Shiefav/KZ6C/hardware/ATTRIBUTION.md

# Hardware attribution

The board design contains footprints from the KiCad libraries. The local
`KZ6C.pretty/USB_C_HRO_TYPE-C-31-M-12.kicad_mod` is adapted from a KiCad library
footprint. KiCad libraries are CC BY-SA 4.0 with the KiCad library exception:
https://www.kicad.org/libraries/license/ . The full CC BY-SA 4.0 text is in
`../LICENSES/CC-BY-SA-4.0.txt`; the KiCad exception is in
`../LICENSES/KICAD-LIBRARY-EXCEPTION.txt`. KiCad copyrights and third-party
notices continue to apply to their original material. Original KZ6C board and
case contributions are distributed under CC BY-SA 4.0, see `../LICENSE`.
