Shiefav/KZ6C/(list of files, cad)

Other CAD files:
case/bottom.dxf
case/spacer.dxf
case/top.dxf
