Shiefav/KZ6C/hardware/kz6c-b02.kicad_pcb

## KiCad design hardware/kz6c-b02.kicad_pcb (2026-11-12)

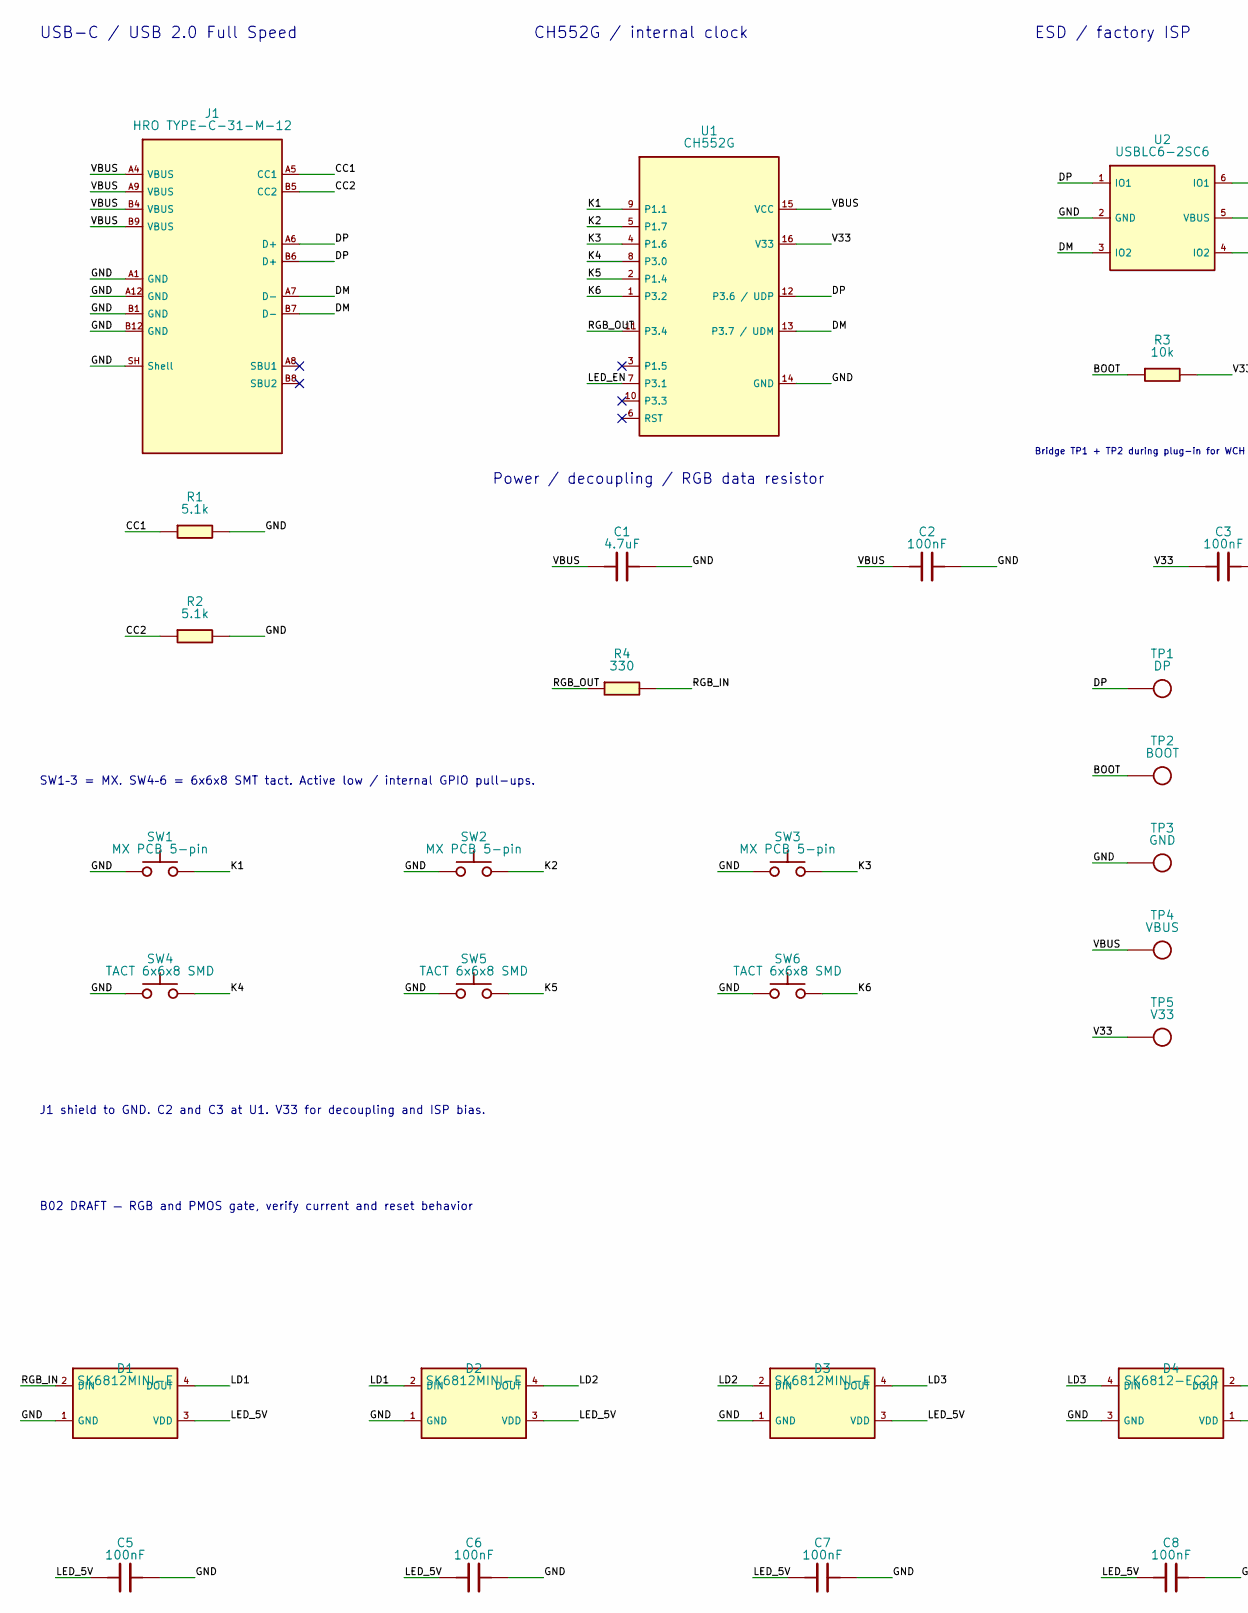
[picture p1: schematic kz6c-b02.kicad_sch, KeypadZone KZ6C, part in row 1, column 1]

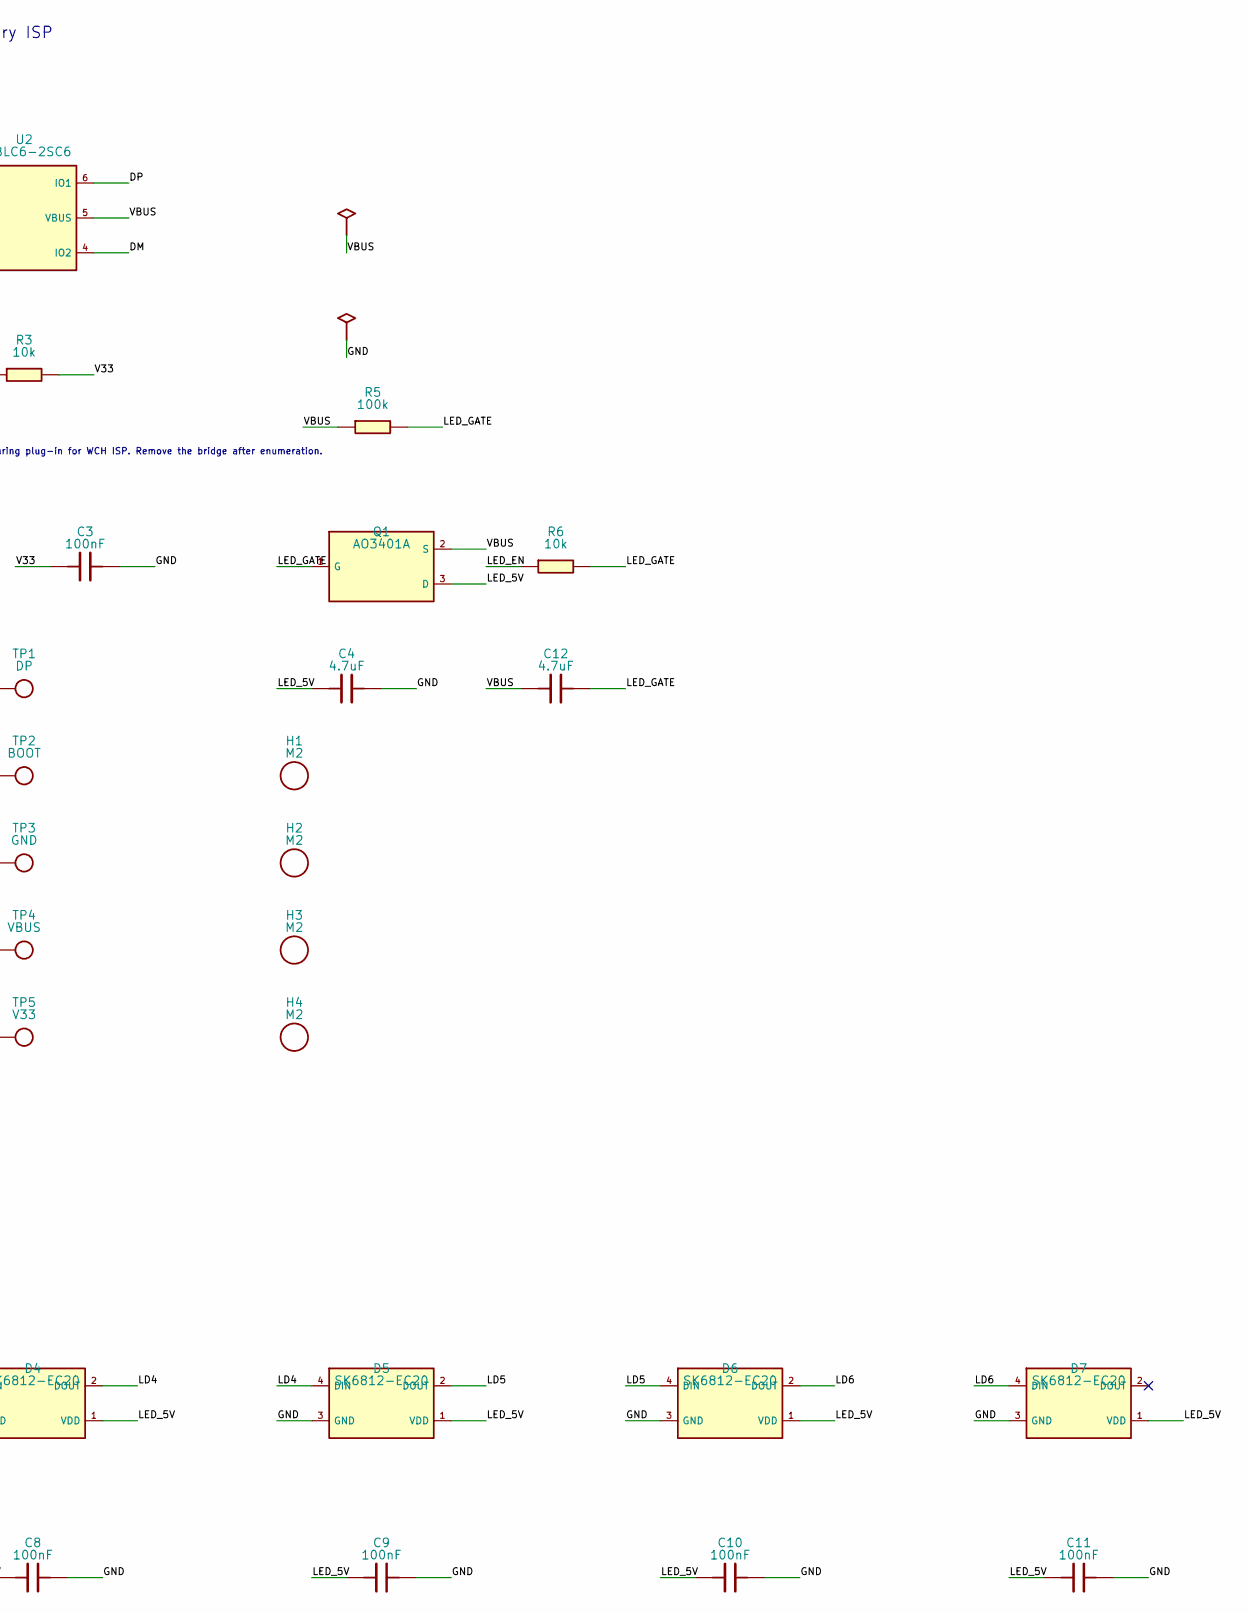
[picture p2: schematic kz6c-b02.kicad_sch, KeypadZone KZ6C, part in row 1, column 2]

Parts:
C1, C4, C12: 4.7uF; C_0805_2012Metric; LCSC Part # C1779
C2, C3, C5, C6, C7, C8, C9, C10, C11: 100nF; C_0805_2012Metric; LCSC Part # C49678
D1, D2, D3: SK6812MINI-E; LED_SK6812MINI-E_3.2x2.8mm_P1.5mm_ReverseMount; LCSC Part # C5149201
D4, D5, D6, D7: SK6812-EC20; LED_SK6812-EC20_2.0x2.0mm; LCSC Part # C2909058
H1, H2, H3, H4: M2; MountingHole_2.2mm_M2
J1: HRO TYPE-C-31-M-12; USB_C_HRO_TYPE-C-31-M-12; LCSC Part # C165948
Q1: AO3401A; SOT-23; LCSC Part # C15127
R1, R2: 5.1k; R_0805_2012Metric; LCSC Part # C27834
R3, R6: 10k; R_0805_2012Metric; LCSC Part # C17414
R4: 330; R_0805_2012Metric; LCSC Part # C17630
R5: 100k; R_0805_2012Metric; LCSC Part # C149504
SW1, SW2, SW3: MX PCB 5-pin; SW_Cherry_MX_1.00u_PCB
SW4, SW5, SW6: TACT 6x6x8 SMD; SW_TACT_6x6_SMD_8.5x4.5
TP1: DP; TestPoint_Pad_D1.0mm
TP2: BOOT; TestPoint_Pad_D1.0mm
TP3: GND; TestPoint_Pad_D1.0mm
TP4: VBUS; TestPoint_Pad_D1.0mm
TP5: V33; TestPoint_Pad_D1.0mm
U1: CH552G; SOIC-16_3.9x9.9mm_P1.27mm; LCSC Part # C111292
U2: USBLC6-2SC6; SOT-23-6; LCSC Part # C7519

Connections:
/BOOT: R3.1, TP2.1
/CC1: J1.A5 (CC1), R1.1
/CC2: J1.B5 (CC2), R2.1
/DM: J1.A7 (D-), J1.B7 (D-), U1.13 (P3.7 / UDM), U2.3 (IO2), U2.4 (IO2)
/DP: J1.A6 (D+), J1.B6 (D+), TP1.1, U1.12 (P3.6 / UDP), U2.1 (IO1), U2.6 (IO1)
/GND: C1.2, C2.2, C3.2, C4.2, C5.2, C6.2, C7.2, C8.2, C9.2, C10.2, C11.2, D1.1 (GND), D2.1 (GND), D3.1 (GND), D4.3 (GND), D5.3 (GND), D6.3 (GND), D7.3 (GND), J1.A1 (GND), J1.A12 (GND), J1.B1 (GND), J1.B12 (GND), J1.SH (Shell), R1.2, R2.2, SW1.1, SW2.1, SW3.1, SW4.1, SW5.1, SW6.1, TP3.1, U1.14 (GND), U2.2 (GND)
/K1: SW1.2, U1.9 (P1.1)
/K2: SW2.2, U1.5 (P1.7)
/K3: SW3.2, U1.4 (P1.6)
/K4: SW4.2, U1.8 (P3.0)
/K5: SW5.2, U1.2 (P1.4)
/K6: SW6.2, U1.1 (P3.2)
/LD1: D1.4 (DOUT), D2.2 (DIN)
/LD2: D2.4 (DOUT), D3.2 (DIN)
/LD3: D3.4 (DOUT), D4.4 (DIN)
/LD4: D4.2 (DOUT), D5.4 (DIN)
/LD5: D5.2 (DOUT), D6.4 (DIN)
/LD6: D6.2 (DOUT), D7.4 (DIN)
/LED_5V: C4.1, C5.1, C6.1, C7.1, C8.1, C9.1, C10.1, C11.1, D1.3 (VDD), D2.3 (VDD), D3.3 (VDD), D4.1 (VDD), D5.1 (VDD), D6.1 (VDD), D7.1 (VDD), Q1.3 (D)
/LED_EN: R6.1, U1.7 (P3.1)
/LED_GATE: C12.2, Q1.1 (G), R5.2, R6.2
/RGB_IN: D1.2 (DIN), R4.2
/RGB_OUT: R4.1, U1.11 (P3.4)
/V33: C3.1, R3.2, TP5.1, U1.16 (V33)
/VBUS: C1.1, C2.1, C12.1, J1.A4 (VBUS), J1.A9 (VBUS), J1.B4 (VBUS), J1.B9 (VBUS), Q1.2 (S), R5.1, TP4.1, U1.15 (VCC), U2.5 (VBUS)

Notes on the sheet:
USB-C / USB 2.0 Full Speed
CH552G / internal clock
ESD / factory ISP
Bridge TP1 + TP2 during plug-in for WCH ISP. Remove the bridge after enumeration.
Power / decoupling / RGB data resistor
SW1–3 = MX. SW4–6 = 6x6x8 SMT tact. Active low / internal GPIO pull-ups.
J1 shield to GND. C2 and C3 at U1. V33 for decoupling and ISP bias.
B02 DRAFT — RGB and PMOS gate, verify current and reset behavior

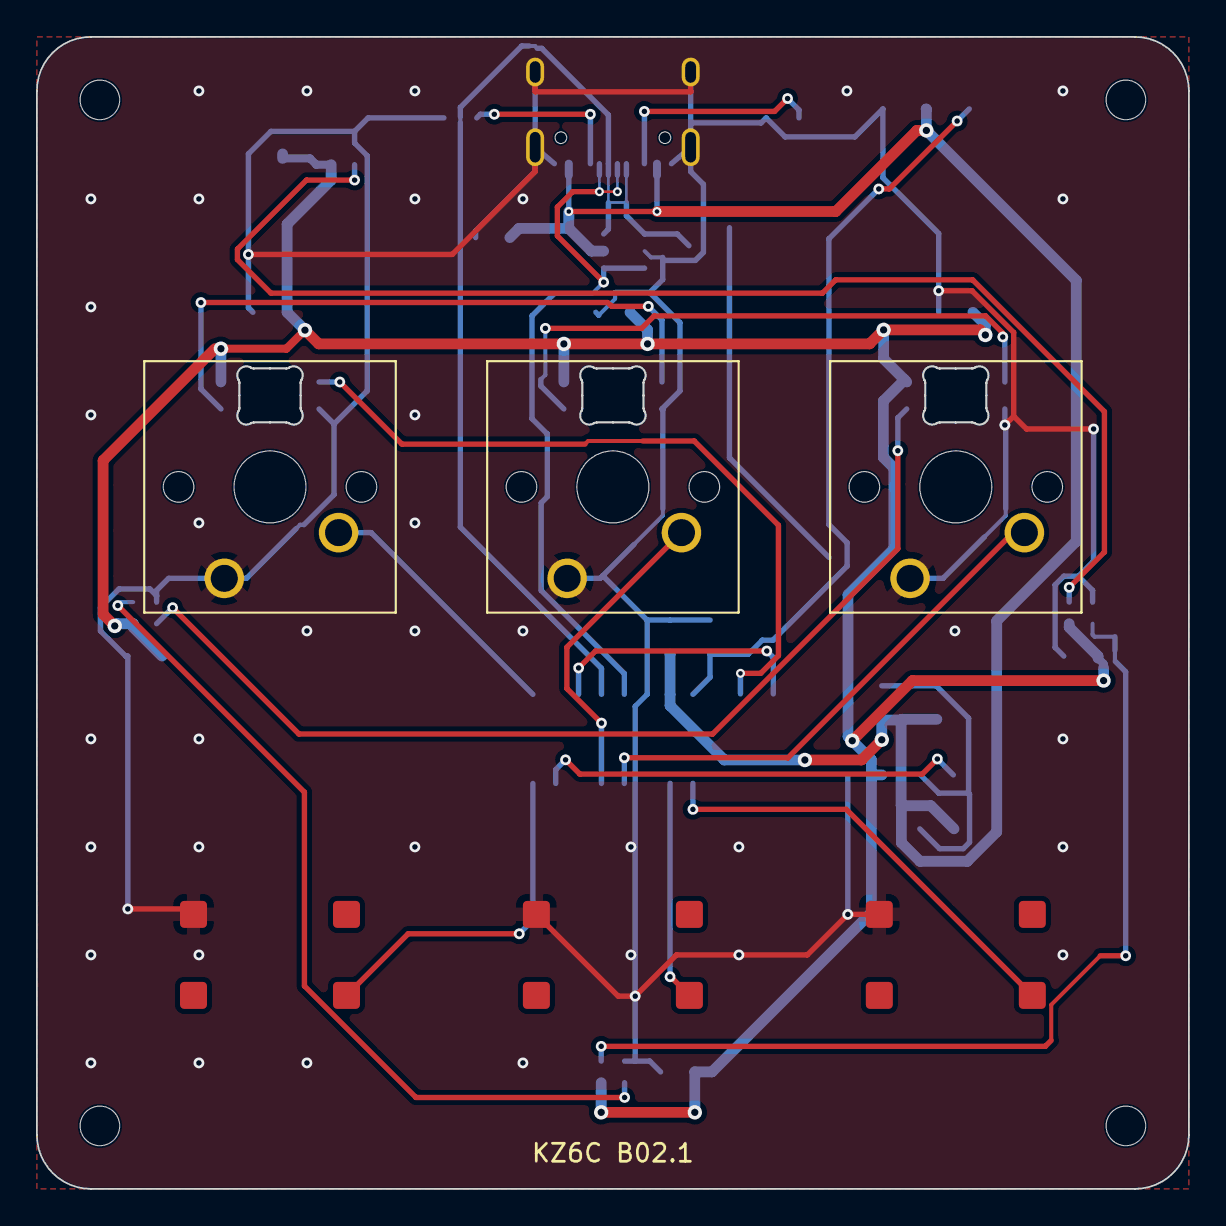
[picture p3: board kz6c-b02.kicad_pcb from above]

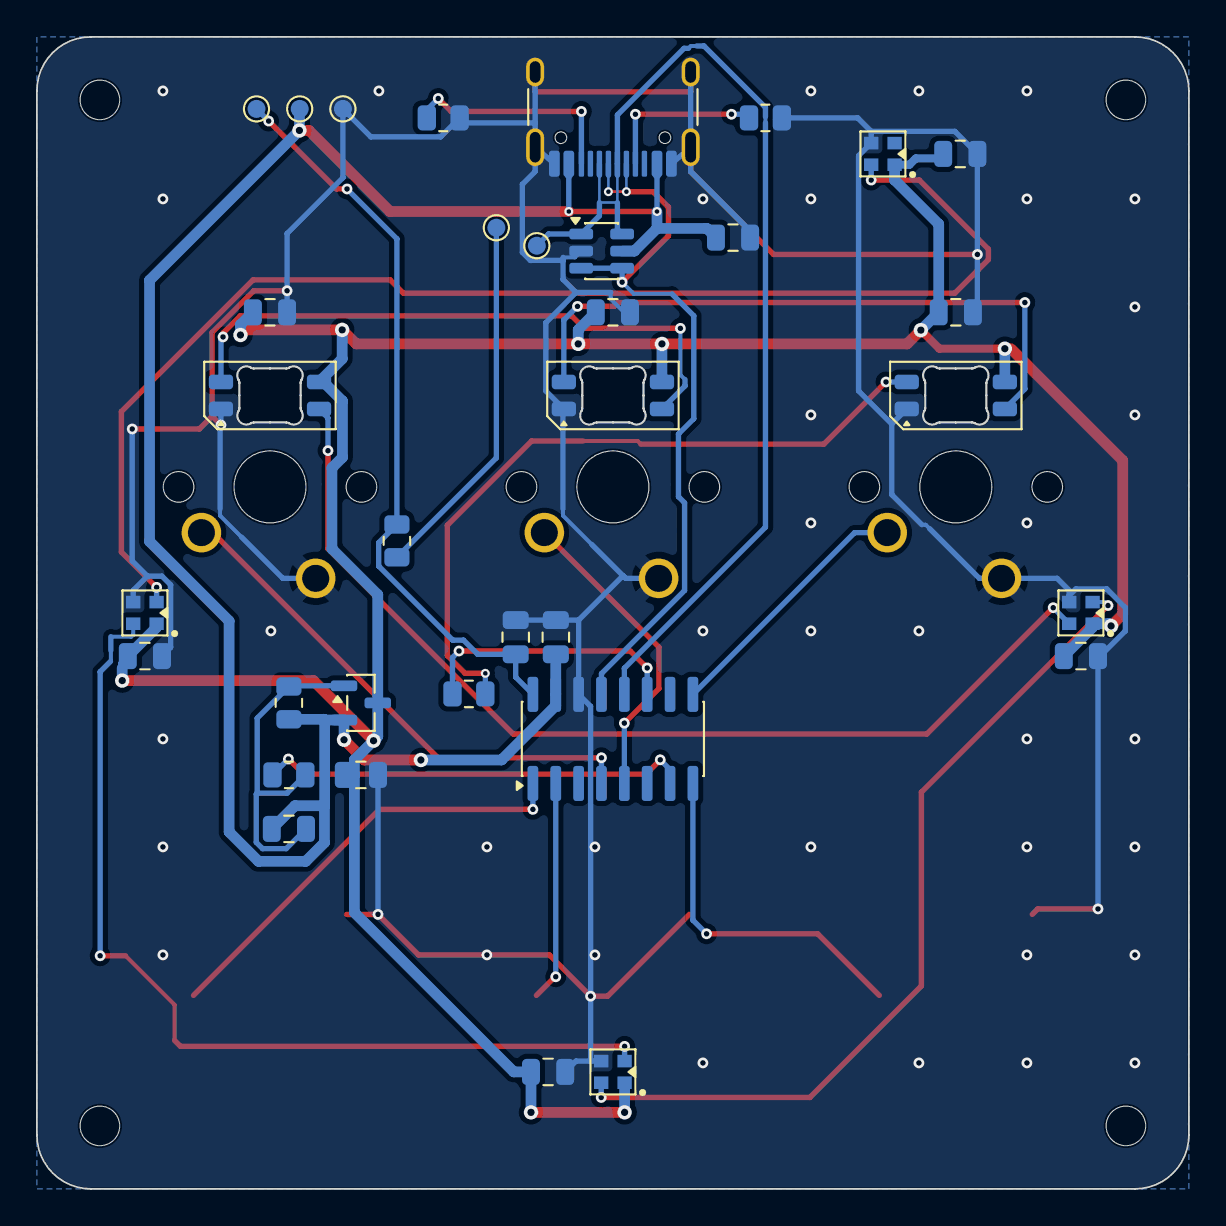
[picture p4: board kz6c-b02.kicad_pcb from below]

Board: 2 copper layers, 64.0 x 64.0 mm, 44 parts (34 on the bottom side), 25 nets.
